HexabitzPlatform/H15R8x-Hardware/README.md

# H15R8x-Hardware
Hexabitz Hi-precision Voltage & Current Analog Output Module Hardware Design
