HexabitzPlatform/H15R8x-Hardware/H15R80/Released/BOM/H15R80.xlsx

 |  | www.hexabitz.com info@hexabitz.com |  |  | Bill Of Materials
Customer | Hexabitz | Revision | 0
Project | Hexabitz Modules | Date | 2022-10-10
Board | Hi-precision Voltage & Current Analog Output (H15R80) | Notes | DNP is Do Not Populate
Designator | Description | Manufacturer | Manufacturer Part Number | Octopart Url | Quantity
JP1 | Conn Unshrouded Header HDR 1 POS Solder ST Top Entry Thru-Hole Carton | TE Connectivity | 103327-1 | https://octopart.com/103327-1-te+connectivity-1934117?r=sp | 1
JP2 | Conn Unshrouded Header HDR 3 POS 2.54mm Solder ST Top Entry Thru-Hole Carton | TE Connectivity | 5-146281-3 | https://octopart.com/5-146281-3-te+connectivity+%2F+amp-39745942?r=sp | 1
AO | Terminal Block 10 A 160 V 3.5 mm 26 to 16 AWG 2 Screw Solder 2.5 kV PA | Phoenix Contact | 1751248 | https://octopart.com/1751248-phoenix+contact-31334?r=sp&s=dfbEyNHiQNetUL69ahOrPQ | 1
PWR | 2pin Terminal Block; Printed Circuit; 10 A; 160 V; 3.5 mm; 2; 3.5 mm; 1.2 mm; M2; PA | Phoenix Contact | 1751251 | https://octopart.com/1751251-phoenix+contact-36473?r=sp&s=9M0VWNoHTyq04j3qI6lQOQ | 1
C1, C3, C5, C8, C18 | Multilayer Ceramic Capacitor, 0.1 uF, 10 V, ± 10%, X7R, 0603 | KEMET | C0603C104K8RACTU | https://octopart.com/c0603c104k8ractu-kemet-145075?r=sp&s=9bS9ASSwSEqMCE9KBEQZ0g | 5
C2 | CAP CER 1 UF 16V X7R 0805 | YAGEO [VA] | CC0805KKX7R7BB105 | https://octopart.com/cc0805kkx7r7bb105-yageo-8376555?r=sp | 1
C4, C7 | CAP TANT 4.7 UF 10V 20% 0805 | Panasonic | 10TPU4R7MSI | https://octopart.com/10tpu4r7msi-panasonic-29487748?r=sp | 2
C13, C16, C19, C20, C22, C25, C31, C33 | Cap Ceramic 0.1uF 50V X7R 10% Pad SMD 0603 125C Automotive T/R | AVX | 06035C104K4T2A | https://octopart.com/06035c104k4t2a-avx-2665160?r=sp | 8
C14, C17, C21, C23, C24, C32, C34 | ultilayer Ceramic Capacitor, 100 pF, 50 V, ± 5%, C0G (NP0), 0603 | Avx | 06035A101JAT2A | https://octopart.com/06035a101jat2a-avx-55386344?r=sp&s=WDfgRo-ITV2A4U5JT5ZyKQ | 7
C12, C15 | 10uF Solid MnO2 Tantalum Electrolytic Capacitor; 50 V dc +/-10%; T491 Series | KEMET | T491D106K050AT | https://octopart.com/t491d106k050at-kemet-968220?r=ap&s=K_G_zr40QourN4WdchG6mQ# | 2
C30 | CAP CER 10% X7R 0603 | TDK | C1608X7R1H223K080AA | https://octopart.com/c1608x7r1h223k080aa-tdk-25947667?r=sp&s=T8cT_uRxS7ewuHBmxCxszg | 1
C26, C27, C28, C29 | CAP CER 0603 |  | DNP |  | 4
R1 | Thick Film Resistors - SMD 0603 270 Ohm 5% Tol | Panasonic | ERJ-3GEYJ271V | https://octopart.com/erj-3geyj271v-panasonic-55560546?r=sp | 1
R2 | RES SMD 0.0OHM JUMPER 1/10W 0603 | YAGEO [VR] | RC0603JR-070RL | https://octopart.com/rc0603jr-070rl-yageo-1241539?r=sp | 1
R3, R5 | RES 10K Ohm 5% 0603 | Vishay | CRCW060310K0JNEB | https://octopart.com/crcw060310k0jneb-vishay-46603269 | 2
R4 | Res General Purpose Thick Film 0603 10 Ohm 5% 1/10W ±200ppm/°C Molded SMD Paper T/R | Yageo | RC0603JR-0710RL | https://octopart.com/rc0603jr-0710rl-yageo-55508099?r=sp | 1
FB1 | Ind chip Bead Multi-Layer 30 ohms 25% 100MHZ Ferrite 1,5A 0603Punched paper T/R | TDK | MMZ1608Y300BTA00 | https://octopart.com/mmz1608y300bta00-tdk-7906990?r=sp | 1
U1 | MCU 32-Bit ARM Cortex-M0+ RISC 512kByte Flash 1.7V to 3.6V 48-Pin UFQFPN Tray | STMicroelectronics | STM32G0B1CEU6N | https://octopart.com/stm32g0b1ceu6n-stmicroelectronics-116364672?r=sp | 1
U2 | 16-Bit Single-Channel Programmable Current/Voltage Output DAC for 4-20mA current loop applications | Texas Instruments | DAC8760IRHAR | https://octopart.com/dac8760irhar-texas+instruments-29661993?r=sp&s=ruhaz_LcRdqODQmkWKrlGA | 1
U3 | Op Amp Single Precision Amplifier R-R I/O ±18V/36V 5-Pin SOT-23 T/R | Texas Instruments | OPA192IDBVR | https://octopart.com/opa192idbvr-texas+instruments-33513820?r=sp&s=D6KF1OAATrGkqNyouFfzCw | 1
D1 | Red 0603 130° Clear 54 mcd 2 V Surface Mount ChipLED | Vishay | VLMS1300-GS08 | https://octopart.com/vlms1300-gs08-vishay-21709201?r=sp&s=0nXJNjGsSbWwqfqWlZv0EA | 1
D2, D3 | 1N5819HW Series 40 V 1 A Surface Mount Schottky Barrier Rectifier - SOD-123 | Diodes Inc. | 1N5819HW-7-F | https://octopart.com/1n5819hw-7-f-diodes+inc.-323197?r=sp | 2
F1, F2 | PTC Resettable Fuse 0.35A(hold) 0.75A(trip) 16VDC 20A 0.6W 0.1s 0.45Ohm SMD Solder Pad 1206 | Littelfuse | NANOSMDC035F-2 | https://octopart.com/nanosmdc035f-2-littelfuse-74215052?r=sp | 2
TVS1, TVS2 | Diode TVS Single Bi-Dir 17V 600W 2-Pin SMB | Bourns | SMBJ17CA | https://octopart.com/smbj17ca-bourns-12809460?r=sp | 2
X1 | 8,0000MHZ 33pF SMD MURATA Resonators | Murata | CSTNE8M00G550000R0 | https://octopart.com/cstne8m00g550000r0-murata-91406934?r=sp | 1
