HexabitzPlatform/H15R8x-Hardware/H15R80/Documentation/H15R80.pdf

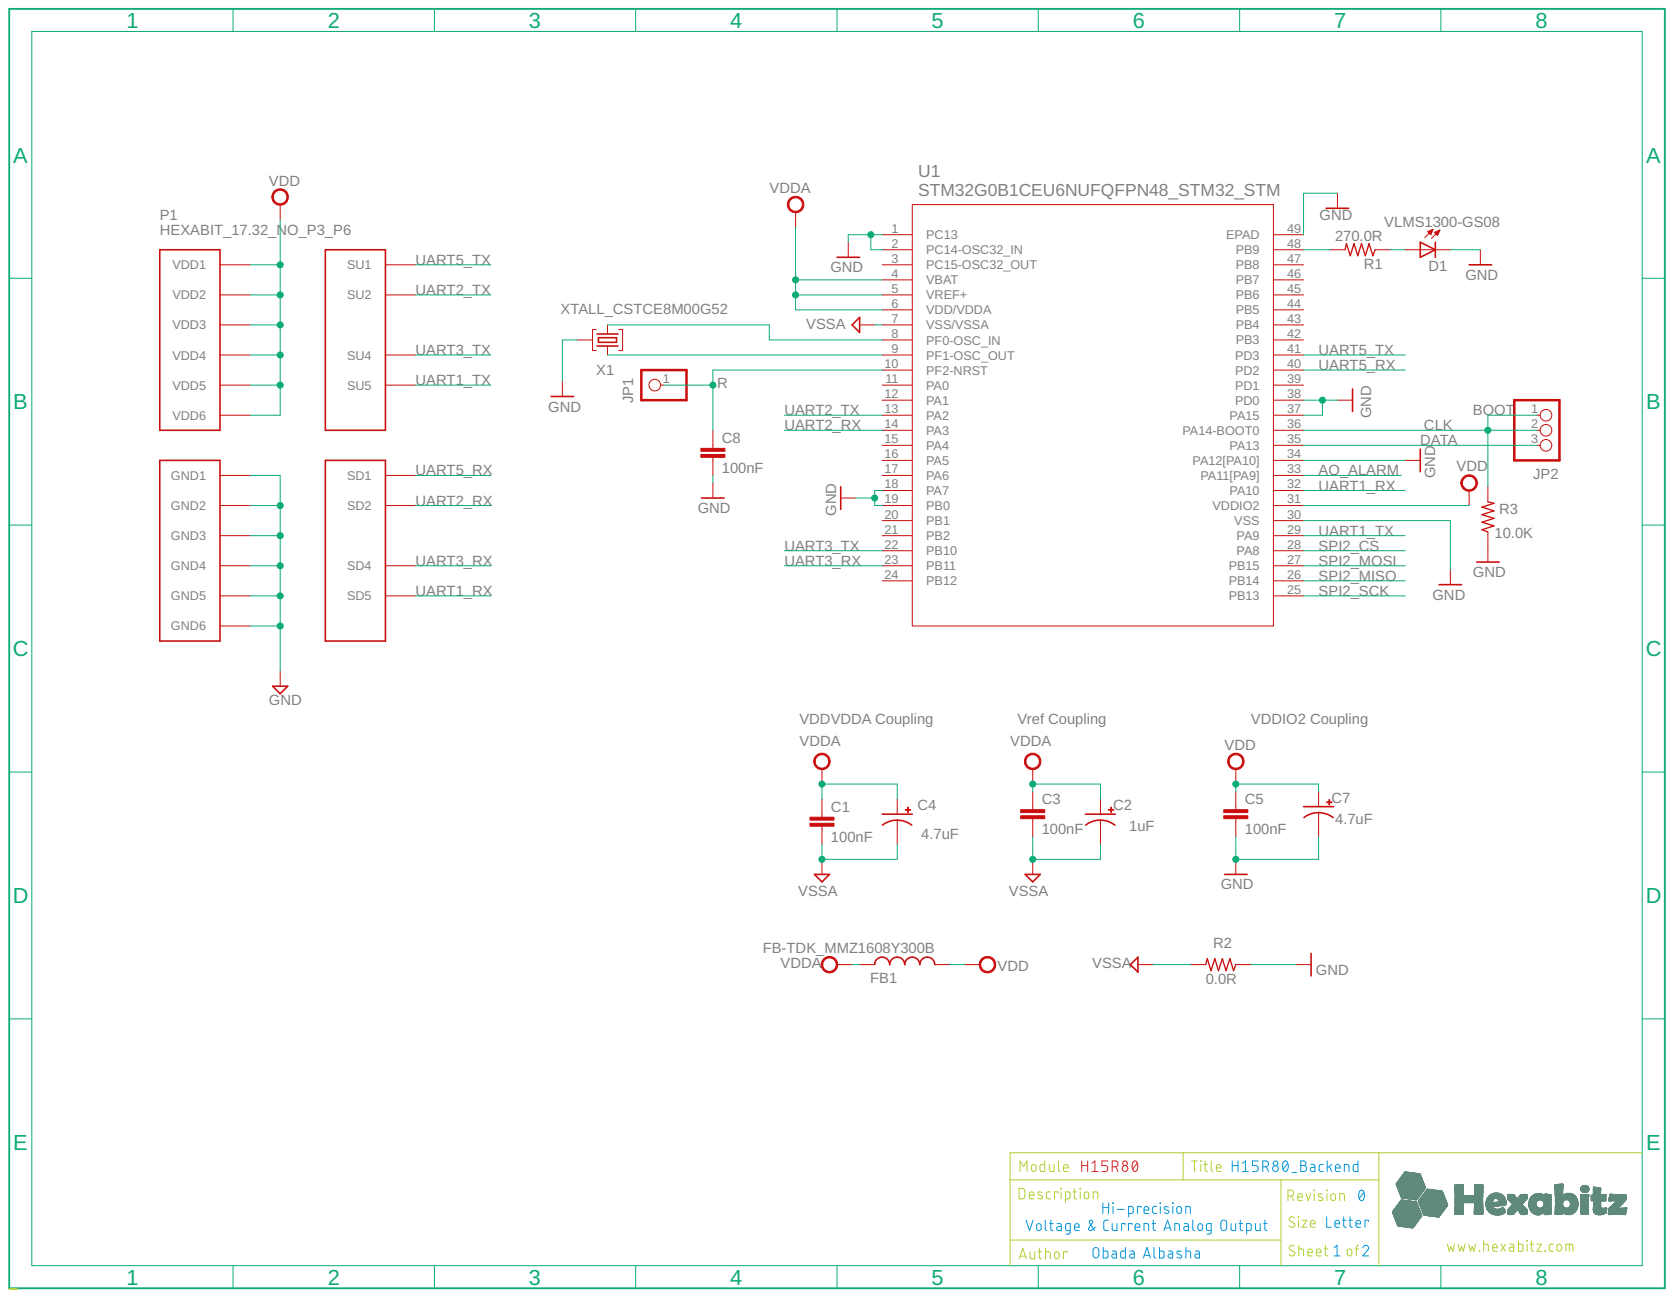
[picture p1: page 1]

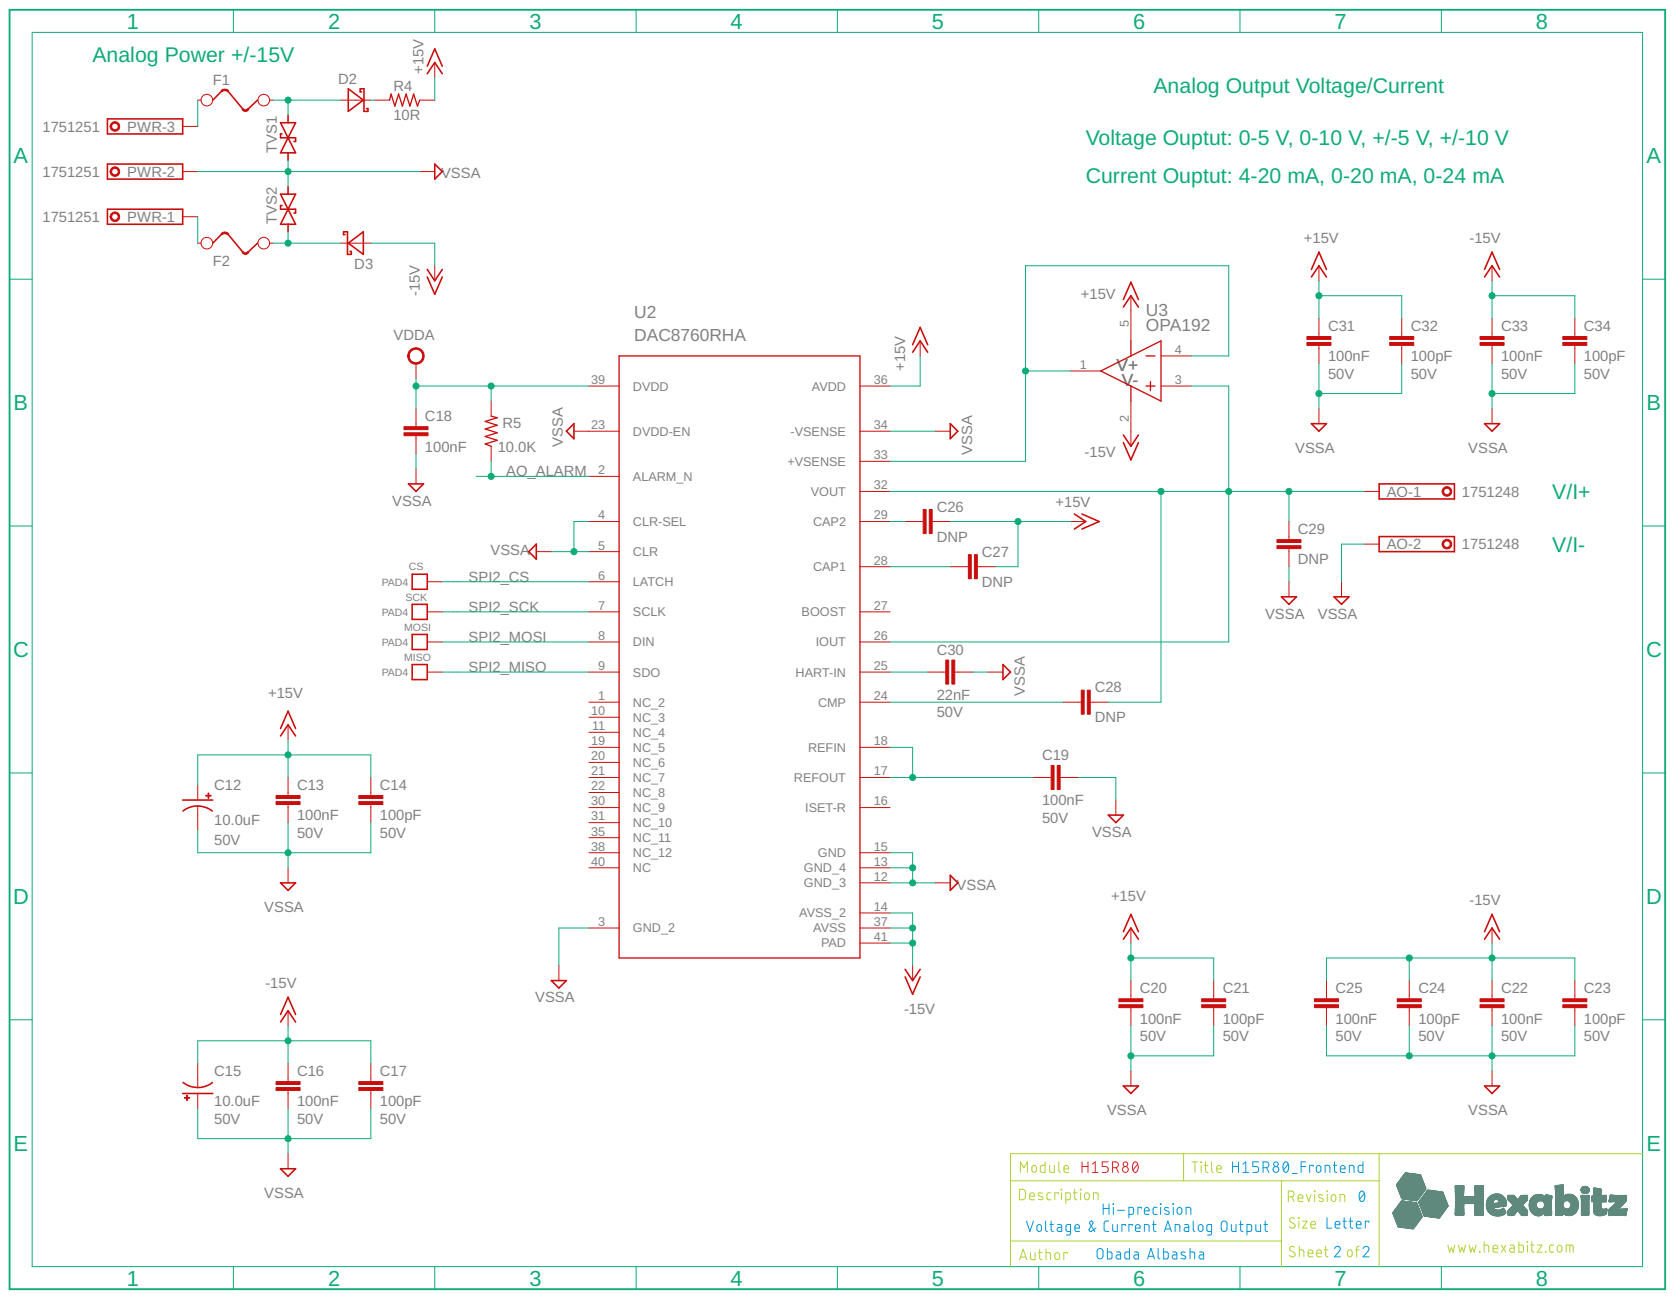
[picture p2: page 2]

Analog Power +/-15V

Analog Output Voltage/Current

Current Ouptut: 4-20 mA, 0-20 mA, 0-24 mA
