HexabitzPlatform/H15R8x-Hardware/Design/H15R80.brd

## EAGLE design Design/H15R80.brd (2020-01-01, an earlier design)

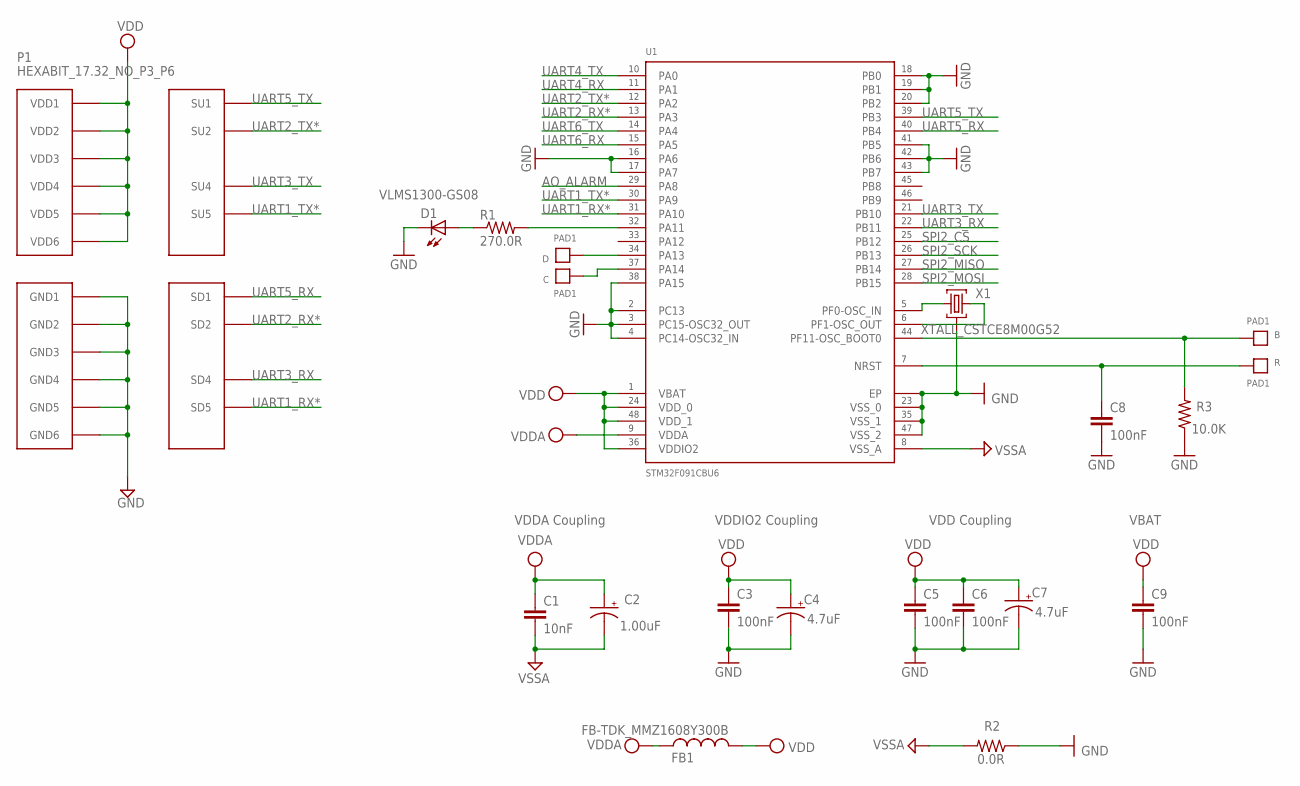
[picture p7: schematic H15R80.sch, sheet 1]

Parts:
B: PAD1
C: PAD1
C1: 10nF; C-0603; TOLERANCE 10%; VOLTAGE_RATING 50V; MPN C0603C103K5RACTU
C2: 1.00uF; C-0805-POL; TOLERANCE 10%; VOLTAGE_RATING 16V; MPN CC0805KKX7R7BB105
C3, C6, C8: 100nF; C-0603; TOLERANCE 10%; VOLTAGE_RATING 10V; MPN C0603C104K8RACTU
C4, C7: 4.7uF; C-0805-POL; TOLERANCE 10%; VOLTAGE_RATING 25V; MPN GRM21BC81E475KA12L
C5: 100nF; C-0603; TOLERANCE 10%; VOLTAGE_RATING 10; MPN C0603C104K8RACTU
C9: 100nF; C-0603; TOLERANCE 10V; VOLTAGE_RATING 10%; MPN C0603C104K8RACTU
D: PAD1
D1: VLMS1300-GS08; MPN VLMS1300-GS08
FB1: FB-TDK_MMZ1608Y300B; MPN MMZ1608Y300B
P1: HEXABIT_17.32_NO_P3_P6
R: PAD1
R1: 270.0R; R-0603; TOLERANCE 1%; MPN RC0603FR-07270RL
R2: 0.0R; R-0603; MPN RC0603JR-070RL
R3: 10.0K; R-0603; TOLERANCE 5%; MPN RC0603JR-0710KL
U1: STM32F091CBU6
X1: XTALL_CSTCE8M00G52

Connections:
AO_ALARM: U1.P$29 (PA8); also elsewhere on the board
B1: B.P$1, B.P$2, R3.2, U1.P$44 (PF11-OSC_BOOT0)
GND: C3.2, C4.2 (-), C5.2, C6.2, C7.2 (-), C8.2, C9.2, D1.C, P1.PAD_PD7 (GND1), P1.PAD_PD8 (GND2), P1.PAD_PD9 (GND3), P1.PAD_PD10 (GND4), P1.PAD_PD11 (GND5), P1.PAD_PD12 (GND6), R2.1, R3.1, U1.EP, U1.P$2 (PC13), U1.P$3 (PC14-OSC32_IN), U1.P$4 (PC15-OSC32_OUT), U1.P$16 (PA6), U1.P$17 (PA7), U1.P$18 (PB0), U1.P$19 (PB1), U1.P$20 (PB2), U1.P$23 (VSS_0), U1.P$35 (VSS_1), U1.P$38 (PA15), U1.P$41 (PB5), U1.P$42 (PB6), U1.P$43 (PB7), U1.P$47 (VSS_2), X1.P$2 (2)
unnamed: R1.2, U1.P$32 (PA11)
unnamed: D1.A, R1.1
unnamed: U1.P$5 (PF0-OSC_IN), X1.P$1 (1)
unnamed: U1.P$6 (PF1-OSC_OUT), X1.P$3 (3)
unnamed: D.P$1, D.P$2, U1.P$34 (PA13)
unnamed: C.P$1, C.P$2, U1.P$37 (PA14)
R1: C8.1, R.P$1, R.P$2, U1.P$7 (NRST)
SPI2_CS: U1.P$25 (PB12); also elsewhere on the board
SPI2_MISO: U1.P$27 (PB14); also elsewhere on the board
SPI2_MOSI: U1.P$28 (PB15); also elsewhere on the board
SPI2_SCK: U1.P$26 (PB13); also elsewhere on the board
UART1_RX*: P1.PAD_PD5 (SD5), U1.P$31 (PA10)
UART1_TX*: P1.PAD_PU5 (SU5), U1.P$30 (PA9)
UART2_RX*: P1.PAD_PD2 (SD2), U1.P$13 (PA3)
UART2_TX*: P1.PAD_PU2 (SU2), U1.P$12 (PA2)
UART3_RX: P1.PAD_PD4 (SD4), U1.P$22 (PB11)
UART3_TX: P1.PAD_PU4 (SU4), U1.P$21 (PB10)
UART4_RX: U1.P$11 (PA1)
UART4_TX: U1.P$10 (PA0)
UART5_RX: P1.PAD_PD1 (SD1), U1.P$40 (PB4)
UART5_TX: P1.PAD_PU1 (SU1), U1.P$39 (PB3)
UART6_RX: U1.P$15 (PA5)
UART6_TX: U1.P$14 (PA4)
VDD: C3.1, C4.1 (+), C5.1, C6.1, C7.1 (+), C9.1, FB1.2, P1.PAD_PU7 (VDD1), P1.PAD_PU8 (VDD2), P1.PAD_PU9 (VDD3), P1.PAD_PU10 (VDD4), P1.PAD_PU11 (VDD5), P1.PAD_PU12 (VDD6), U1.P$1 (VBAT), U1.P$24 (VDD_0), U1.P$36 (VDDIO2), U1.P$48 (VDD_1)
VDDA: C1.1, C2.1 (+), FB1.1, U1.P$9 (VDDA); also elsewhere on the board
VSSA: C1.2, C2.2 (-), R2.2, U1.P$8 (VSS_A); also elsewhere on the board

Notes on the sheet:
VDDA Coupling
VDDIO2 Coupling
VDD Coupling
VBAT

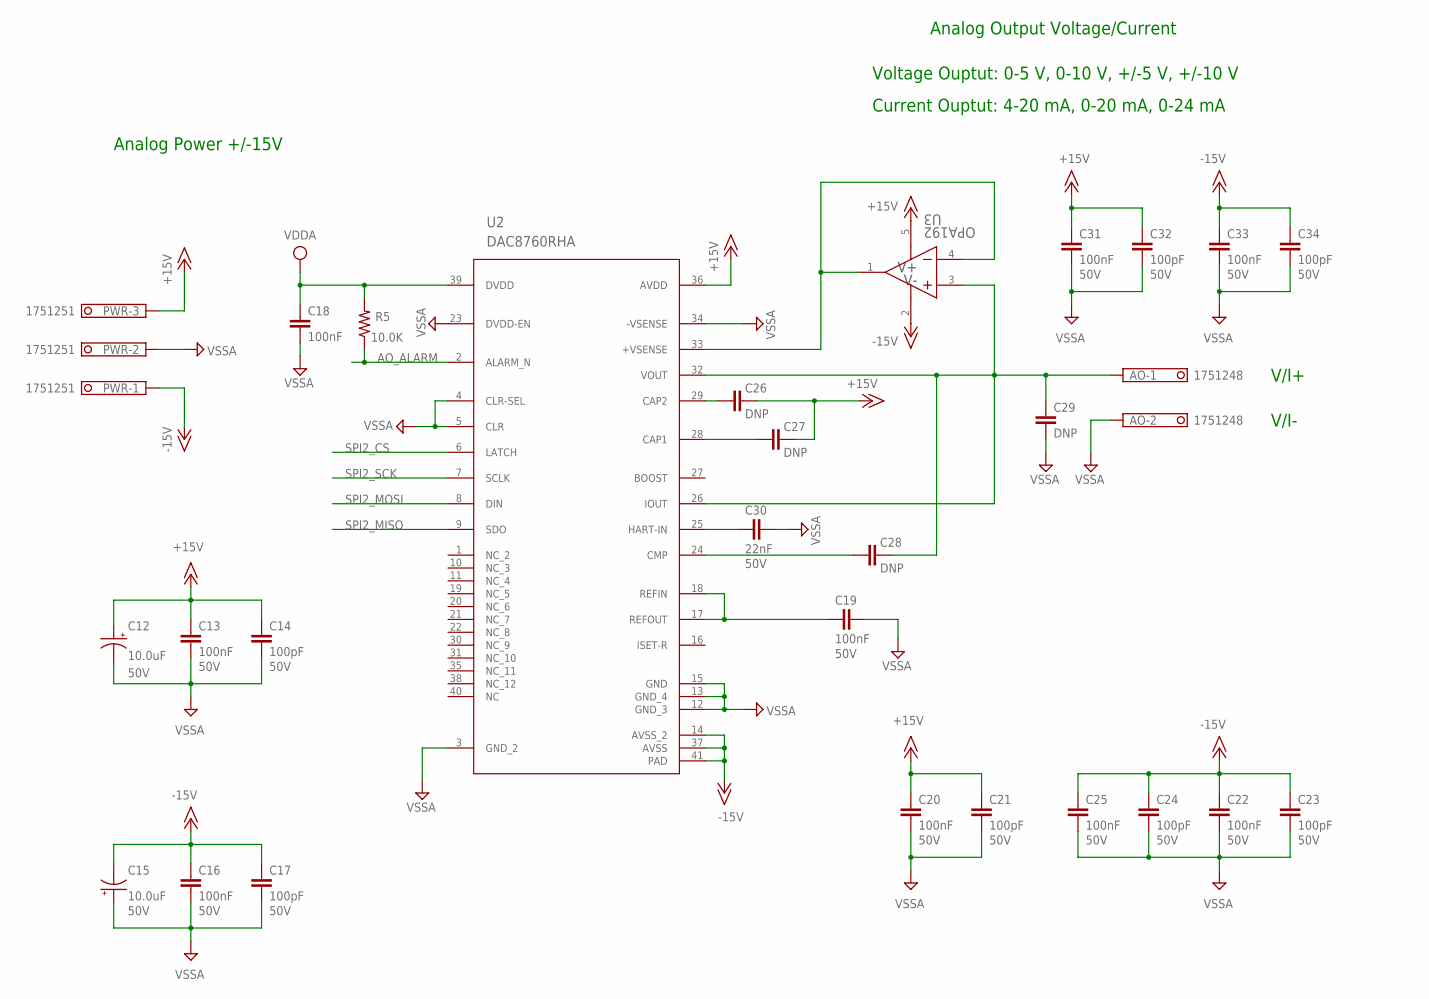
[picture p8: schematic H15R80.sch, sheet 2]

Parts:
AO: 1751248; MPN 1751248
C12, C15: 10.0uF; CT7343; VOLTAGE 50V; MPN T491D106K050AT
C13, C16, C19, C20, C22, C25, C31, C33: 100nF; C-0603; TOLERANCE 10%; VOLTAGE_RATING 50V; MPN CL10B104KB8NNNC
C14, C17, C21, C23, C24, C32, C34: 100pF; C-0603; TOLERANCE 10%; VOLTAGE_RATING 50V; MPN 06035A101JAT2A
C18: 100nF; C-0603; TOLERANCE 10%; VOLTAGE_RATING 10V; MPN C0603C104K8RACTU
C26, C27, C28, C29: DNP; C-0603; MPN DNP
C30: 22nF; C-0603; TOLERANCE 10%; VOLTAGE_RATING 50V; MPN C1608X7R1H223K080AA
PWR: 1751251; MPN 1751251
R5: 10.0K; R-0603; TOLERANCE 5%; MPN RC0603JR-0710KL
U2: DAC8760RHA; RHA0040A
U3: OPA192; DBV0005A_N; MPN OPA192IDBVR

Connections:
+15V: C12.+, C13.1, C14.1, C20.1, C21.1, C26.2, C27.2, C31.1, C32.1, PWR.3, U2.36 (AVDD), U3.5 (V+)
-15V: C15.-, C16.1, C17.1, C22.1, C23.1, C24.1, C25.1, C33.1, C34.1, PWR.1, U2.14 (AVSS_2), U2.37 (AVSS), U2.41 (PAD), U3.2 (V-)
AO_ALARM: R5.1, U2.2 (ALARM_N); also elsewhere on the board
unnamed: AO.1, C28.2, C29.2, U2.26 (IOUT), U2.32 (VOUT), U3.3 (IN+)
unnamed: C19.1, U2.17 (REFOUT), U2.18 (REFIN)
unnamed: C26.1, U2.29 (CAP2)
unnamed: C27.1, U2.28 (CAP1)
unnamed: C28.1, U2.24 (CMP)
unnamed: U2.33 (+VSENSE), U3.1 (OUT), U3.4 (IN-)
unnamed: C30.1, U2.25 (HART-IN)
SPI2_CS: U2.6 (LATCH); also elsewhere on the board
SPI2_MISO: U2.9 (SDO); also elsewhere on the board
SPI2_MOSI: U2.8 (DIN); also elsewhere on the board
SPI2_SCK: U2.7 (SCLK); also elsewhere on the board
VDDA: C18.1, R5.2, U2.39 (DVDD); also elsewhere on the board
VSSA: AO.2, C12.-, C13.2, C14.2, C15.+, C16.2, C17.2, C18.2, C19.2, C20.2, C21.2, C22.2, C23.2, C24.2, C25.2, C29.1, C30.2, C31.2, C32.2, C33.2, C34.2, PWR.2, U2.3 (GND_2), U2.4 (CLR-SEL), U2.5 (CLR), U2.12 (GND_3), U2.13 (GND_4), U2.15 (GND), U2.23 (DVDD-EN), U2.34 (-VSENSE); also elsewhere on the board

Notes on the sheet:
Analog Power +/-15V
Analog Output Voltage/Current
Voltage Ouptut: 0-5 V, 0-10 V, +/-5 V, +/-10 V
Current Ouptut: 4-20 mA, 0-20 mA, 0-24 mA
V/I+
V/I-

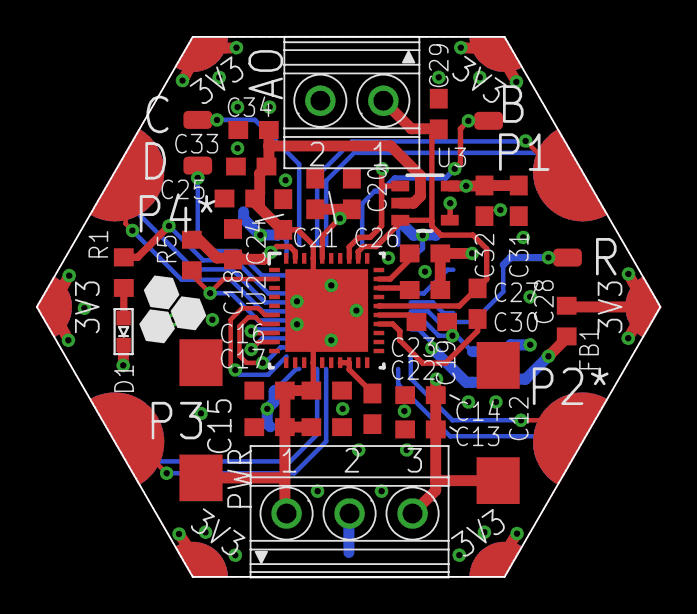
[picture p9: board Design/H15R80.brd from above]

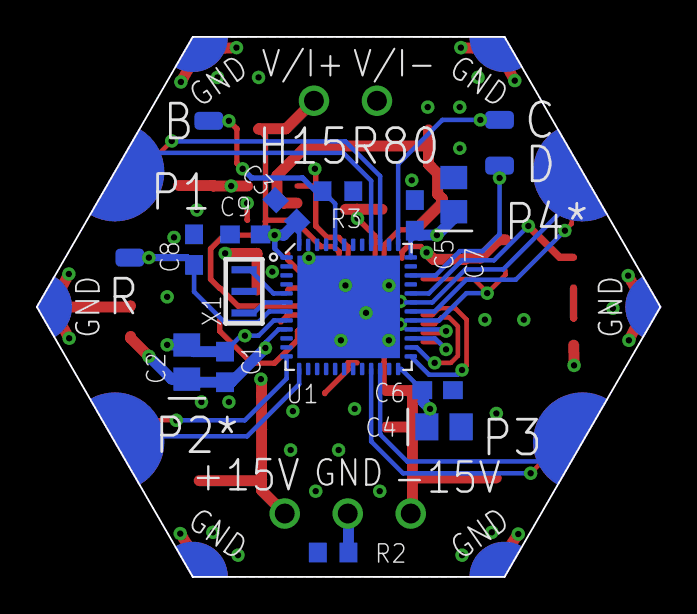
[picture p10: board Design/H15R80.brd from below]

Board: 4 copper layers, 34.6 x 30.0 mm, 49 parts (13 on the bottom side), 34 nets.
