HexabitzPlatform/H15R8x-Hardware/(commit log)

2019-12-20 Generated template files Added connectors and DAC component
    [H15R80.brd, H15R80.sch]
2019-12-21 Finished schematics
    [H15R80.brd, H15R80.sch]
2019-12-23 Placed most components Routed analog routes
    [H15R80.brd, H15R80.sch]
2019-12-24 Routing digital section
    [H15R80.brd, H15R80.sch]
2019-12-30 Finished routing and silkscreen placement
    [H15R80.brd, H15R80.sch]
2020-01-01 Solved DRC
    [H15R80.brd]
2020-01-01 Added schematics PDF, drill, gerber, pick n place files
    [H26R00.xlsx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]
2020-01-01 Added BOM. Release V0
    [H15R80.brd, H15R80.sch, H15R80.xlsx, H26R00.xlsx]
2022-11-09 Changing MCU to STM32G0
    [H15R80.brd, H15R80.sch, H15R80.xlsx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]
2023-02-16 Replace the blind vias with through hole ones
    [H15R80.brd, H15R80.sch, H15R80.xlsx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]
2023-02-16 -Correcting some documentaion issues
    [H15R80.xlsx]
